ManfredFr/CO2-Sensor-Zigbee-Rust/(commit log)

2026-07-04 Baseline: project state before the Rust port (v1.3 firmware, early Rust prototype)
2026-07-05 Rust: std/ESP-IDF scaffold with Zigbee SDK bindings building
    esp-idf-svc + esp-zigbee-lib 1.6 as remote component; bindgen generates
    esp_zb_* FFI. Target dir and workspace anchor moved to ~/.cache (ESP-IDF
    cannot handle spaces in paths). S8 UART + WS2812 LED ported to esp-idf-hal.
    [partitions.csv]
2026-07-05 Rust: full Zigbee port — 3 endpoints, S8 UART, LED, compiles and links
    EP1 temp-as-CO2 carrier, EP2 report interval, EP3 LED brightness via raw
    esp_zb_* FFI; signal handler + SET_ATTR_VALUE action handler; reporting
    under the Zigbee lock. --undefined=vsnprintf works around the late-scanned
    closed-source phy lib in the single-pass link.
2026-07-05 Rust: firmware runs on device — stack up, steering for network
    Fix signal-type double deref (load fault) and bypass esp-idf-hal's UART
    config (panics on ESP32-H2: default source clock PLL_F48M unmapped) with
    raw ESP-IDF UART FFI.
    [main.rs, zigbee.rs]
2026-07-05 v2.0: Rust port verified end-to-end; update docs
    CO2 reporting, interval and brightness read/write all confirmed working
    against Zigbee2MQTT with the unchanged Co2-Sensor.js converter.
2026-07-05 CLAUDE.md: current firmware is v2.0 Rust; note working device address
2026-07-05 Fix WS2812 LED: replace legacy RMT driver with new RMT TX driver via FFI
    esp-idf-hal's rmt-legacy driver derives wrong pulse timing on the ESP32-H2,
    leaving the LED dark. New driver at 10 MHz tick resolution, bytes encoder,
    MSB first. Verified on device: boot flash + orange at ~1200 ppm.
    [main.rs]
2026-07-05 Remove legacy v1.3 firmware; Rust v2.0 is the only firmware
    Co2-Sensor.js (Z2M converter) stays — shared by both firmwares and
    unchanged since v1.3. Arduino sources remain in git history.
2026-07-05 README: expand with project overview, features, pinout diagrams, exact wiring
2026-07-05 README: fix markdown rendering — table out of list, unwrap prose lines
2026-07-05 Document source thoroughly: module docs, threading rules, FFI rationale
    No behavior change (co2_color extracted as a named helper). Explains the
    temperature-as-CO2-carrier design, the stack's threading/callback rules,
    the binding-vs-report pitfall, and every H2-specific FFI workaround inline
    where the code lives.
    [main.rs, zigbee.rs]
2026-07-05 Report firmware version on Z2M About page via swBuildId + dateCode
    The Basic cluster's swBuildId/dateCode attributes surface as 'Firmware ID'
    on Zigbee2MQTT's device About page after an interview. Verified: v2.0 /
    20260705 now shown.
2026-07-05 Consolidate version into src/version.rs; derive all ZCL strings
    MAJOR/MINOR/DATE_CODE in one place drive the boot banner, appVersion,
    swBuildId, and dateCode. Hand-counted ZCL length prefixes replaced by a
    zcl_string() helper (length-prefixed, leaked once at endpoint setup).
    [main.rs, version.rs, zigbee.rs]
2026-07-05 v2.0.1: standalone mode — don't block on Zigbee join
    Measuring and LED start at boot; settings are pushed once on the first
    successful join instead. Version scheme now MAJOR.MINOR.PATCH.
2026-07-05 v2.1.0: offline CO2 history logging + USB retrieval tool
    One record/min into a co2_log flash ring (384 KB, ~34 days). Records are
    (boot_count, uptime_s, ppm); tools/read-log.py pulls the partition via
    espflash and reconstructs timestamps. Verified on device end-to-end.
    [partitions.csv]
